VishwakGanesan/Smart-Radar/2_buzzer_driver.png

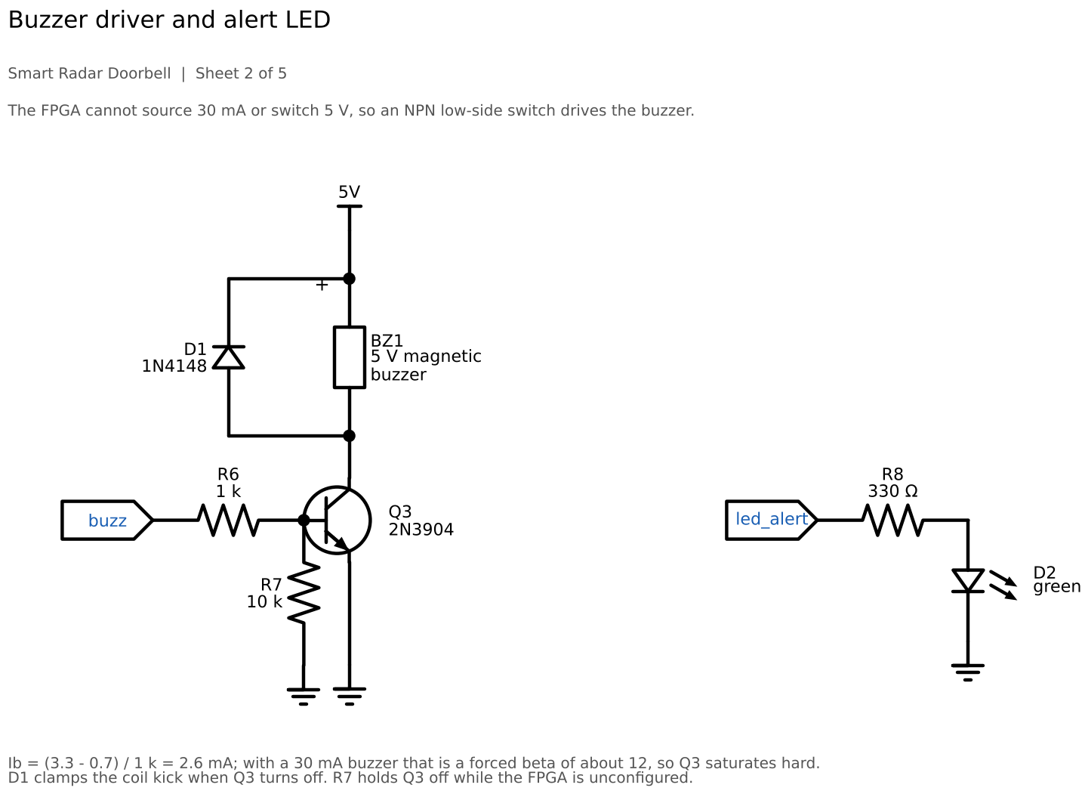
2_buzzer_driver.png
