VishwakGanesan/Smart-Radar/3_button_input.png

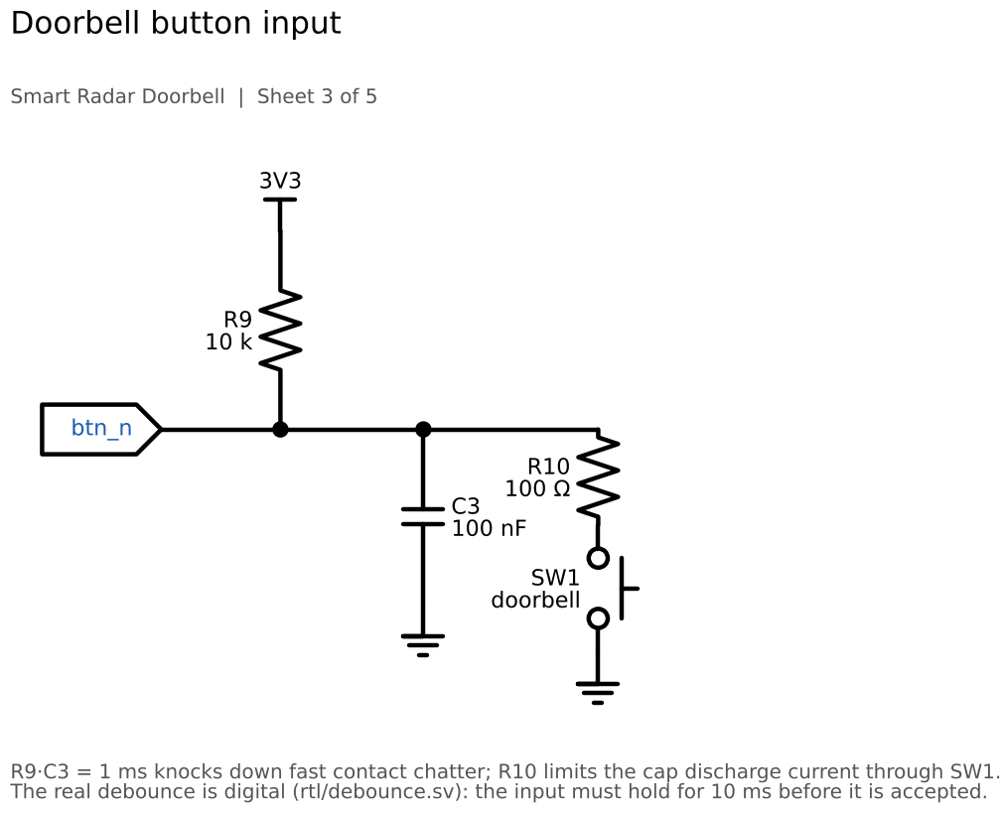
3_button_input.png
