VishwakGanesan/Smart-Radar/4_display_drivers.png

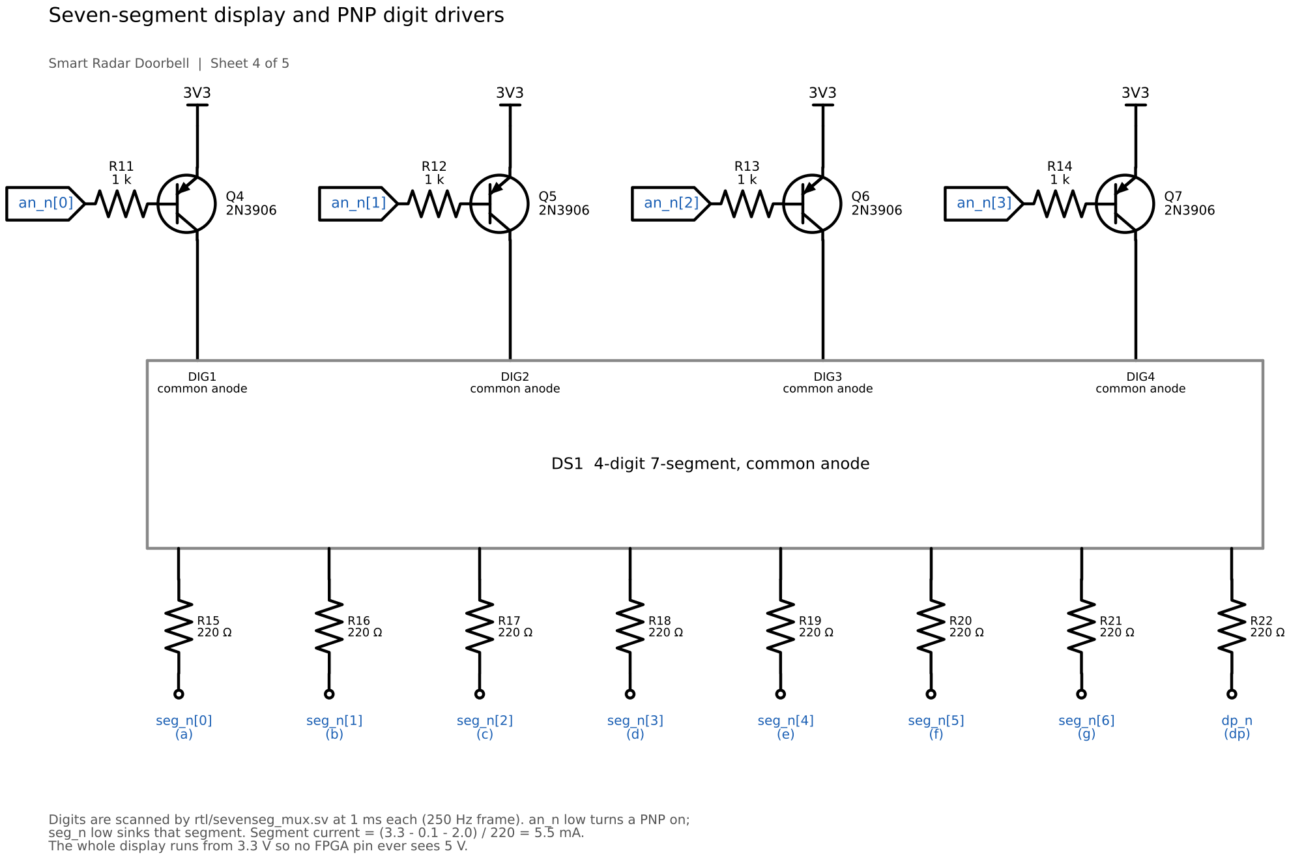
4_display_drivers.png
