VishwakGanesan/Smart-Radar/5_power.png

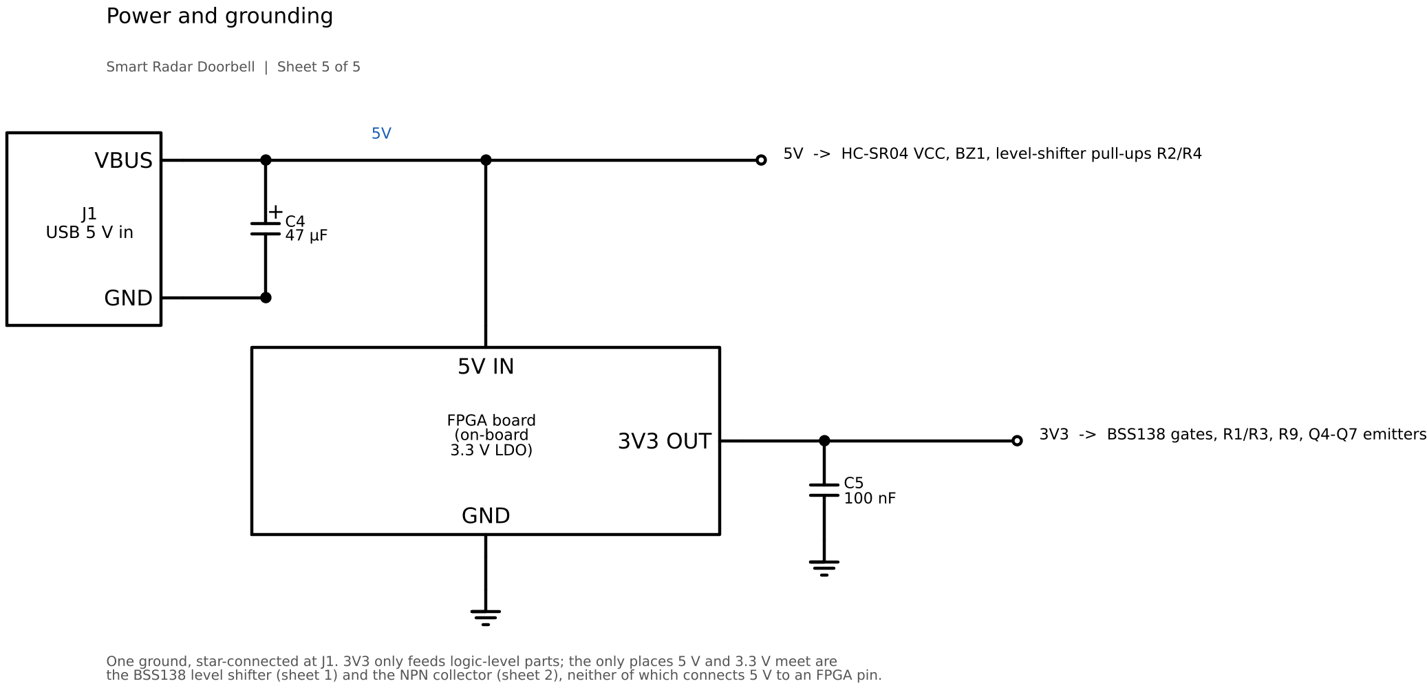
5_power.png
